ratnahartayu/waterflow-meter/dokumen/Proposal Sistem Monitoring Toren Air Desa Berbasis IoT.docx

PROPOSAL

Sistem Monitoring Toren Air Desa Berbasis IoT

Pemantauan jarak jauh air masuk, air keluar, dan isi toren di lima desa Kabupaten Tuban

Disusun oleh

Ir. Ratna Hartayu, M.T.

Program Studi S1 Teknik Elektro

Fakultas Teknologi Elektro dan Informatika Cerdas

Universitas 17 Agustus 1945 Surabaya

Oktober 2026

# 1. Ringkasan

Proposal ini mengajukan pemasangan sistem monitoring berbasis IoT pada lima toren air bersih di lima desa Kabupaten Tuban (Mander, Bader, Tuwiri Kulon, Kabluan, dan Ngulahan), dengan biaya dasar sekitar Rp4,9 juta per lokasi, total Rp28,9 juta termasuk perjalanan tim dan cadangan komponen, dan anggaran yang diajukan Rp33,2 juta setelah cadangan risiko dan cadangan manajemen dihitung dengan metode manajemen proyek. Tiap toren diberi tiga titik ukur: meter air masuk dari pompa, meter air keluar ke warga, dan sensor isi toren. Dari ketiganya server menghitung neraca air harian, sehingga pengelola tahu bukan hanya berapa air yang dipakai warga, tetapi juga apakah air yang dipompa sampai ke warga atau hilang di toren. Semua dipantau dari ponsel lewat dashboard dan grup Telegram.

# 2. Latar belakang

Di lima desa mitra, air bersih bersumber dari sumur bor bantuan Rotary. Pompa listrik PLN di rumah pompa mengisi toren plastik 2.000 liter di atas atapnya, lalu air mengalir secara gravitasi ke rumah warga lewat pipa ½ sampai 1½ inci. Pengelola di tiap desa belum punya catatan berapa air yang dipompa, berapa yang sampai ke warga, dan berapa lama pompa bekerja setiap hari. Pemakaian hanya diketahui dari seberapa sering pompa menyala dan dari keluhan warga saat air tidak sampai ke rumah paling ujung.

Tanpa data, beberapa masalah sulit dikenali. Kebocoran pipa distribusi baru ketahuan setelah tanah becek. Toren yang rembes atau luber karena pelampung rusak membuang air dan listrik tanpa ada yang tahu. Iuran air dipukul rata tanpa dasar volume. Pengelola juga tidak bisa membedakan pompa yang bekerja normal dengan pompa yang berputar tanpa mengangkat air karena sumur mengering.

Dengan toren sekecil 2.000 liter dan pemakaian harian 4 sampai 12 m³, pompa mengisi ulang beberapa kali sehari. Setiap siklus pengisian adalah kesempatan untuk mencocokkan air yang dipompa dengan kenaikan isi toren, dan setiap malam adalah kesempatan untuk memastikan toren tidak bocor saat tidak ada yang memakai air. Monitoring jarak jauh membuat pencocokan itu berjalan otomatis di lima desa yang berjauhan tanpa petugas harus datang.

# 3. Tujuan dan manfaat

Kegiatan ini bertujuan memasang dan mengoperasikan sistem monitoring toren di lima desa serta melatih pengelola tiap desa membaca dan memanfaatkan datanya. Sasaran yang ingin dicapai:

1. Tersedianya catatan harian air masuk dari pompa, air keluar ke warga, dan isi toren di tiap desa dengan ketelitian 10 liter.
2. Neraca air harian tiap toren terhitung otomatis dan selisih di atas 4 persen dilaporkan ke pengelola.
3. Peringatan otomatis lewat Telegram saat ada aliran malam mencurigakan, toren bocor, toren luber, pompa bekerja tanpa hasil, atau aliran berhenti di siang hari.
4. Sepuluh orang pengelola (dua per desa) terlatih mengoperasikan dashboard dan merawat alat sendiri.

Manfaat bagi pengelola air desa: dasar yang terukur untuk iuran, deteksi dini kebocoran dan luapan, serta data jam kerja pompa untuk memperkirakan biaya listrik dan umur pompa. Manfaat bagi warga: pasokan lebih stabil karena gangguan cepat diketahui, iuran lebih adil. Manfaat bagi perguruan tinggi: lima lokasi penerapan nyata untuk riset dan tugas akhir mahasiswa di bidang IoT dan sistem kendali, dengan model yang bisa direplikasi ke desa lain.

# 4. Gambaran sistem

Pada tiap toren dipasang tiga alat ukur yang terhubung ke satu node ESP32 di dalam rumah pompa. Node mengirim data setiap 15 menit lewat jaringan 4G ke server, dan server menghitung neraca air: air masuk dikurangi air keluar harus sama dengan perubahan isi toren. Selisih yang menetap berarti toren bocor, luber, atau salah satu meteran bermasalah (Gambar 1).

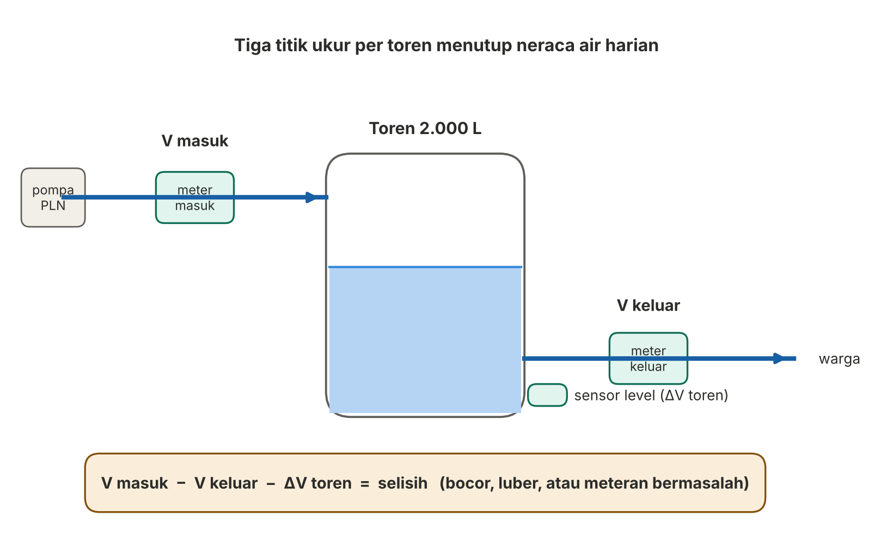
[picture p1: figure]

Gambar 1. Neraca air toren dengan tiga titik ukur

Tiga pengukuran diperlukan karena dengan dua saja persamaannya tidak tertutup. Bila hanya level dan meter keluar, air masuk bisa dihitung dari kenaikan level, tetapi kebocoran toren ikut tersembunyi di dalamnya. Bila hanya meter masuk dan keluar, air yang hilang tidak bisa dibedakan dari air yang memang sedang tersimpan. Gambar 2 memperlihatkan susunan sistem dalam empat lapisan dan Gambar 3 blok diagram perangkat keras di rumah pompa.

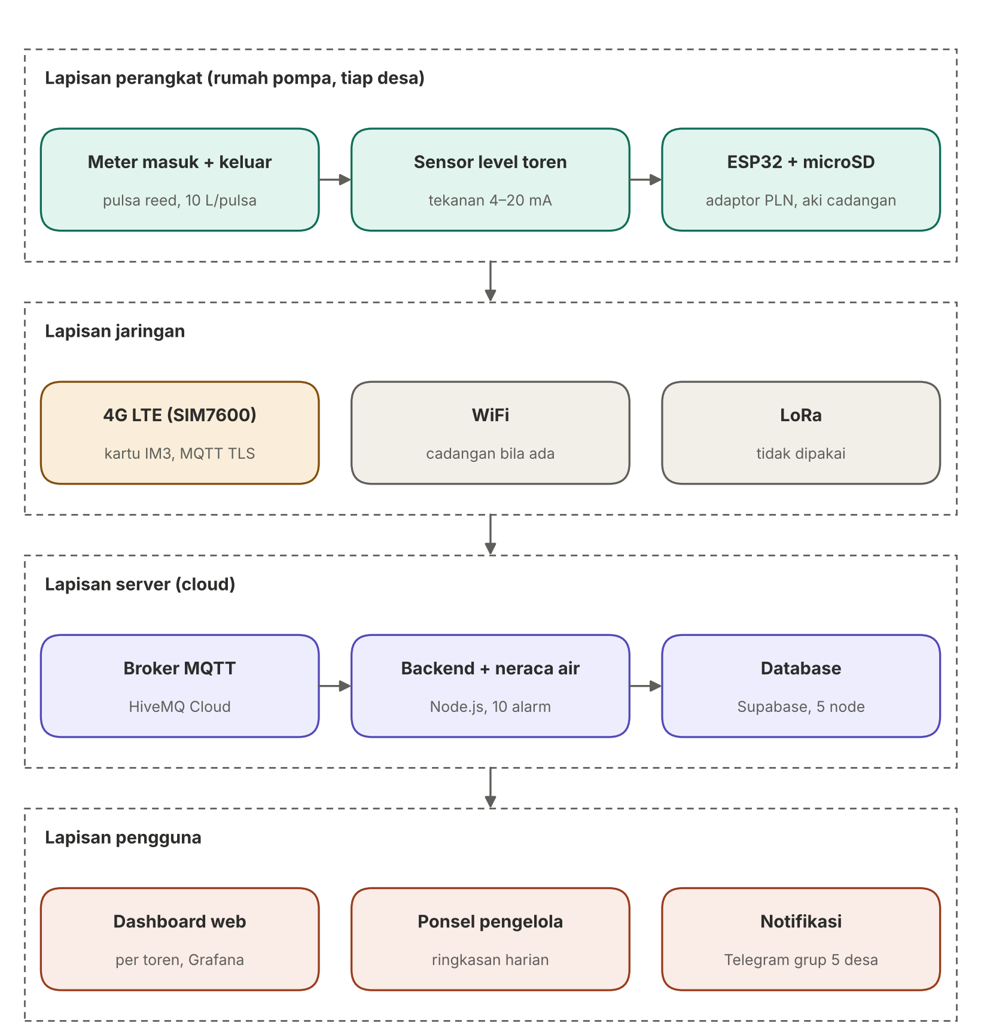
[picture p2: figure]

Gambar 2. Arsitektur sistem dalam empat lapisan

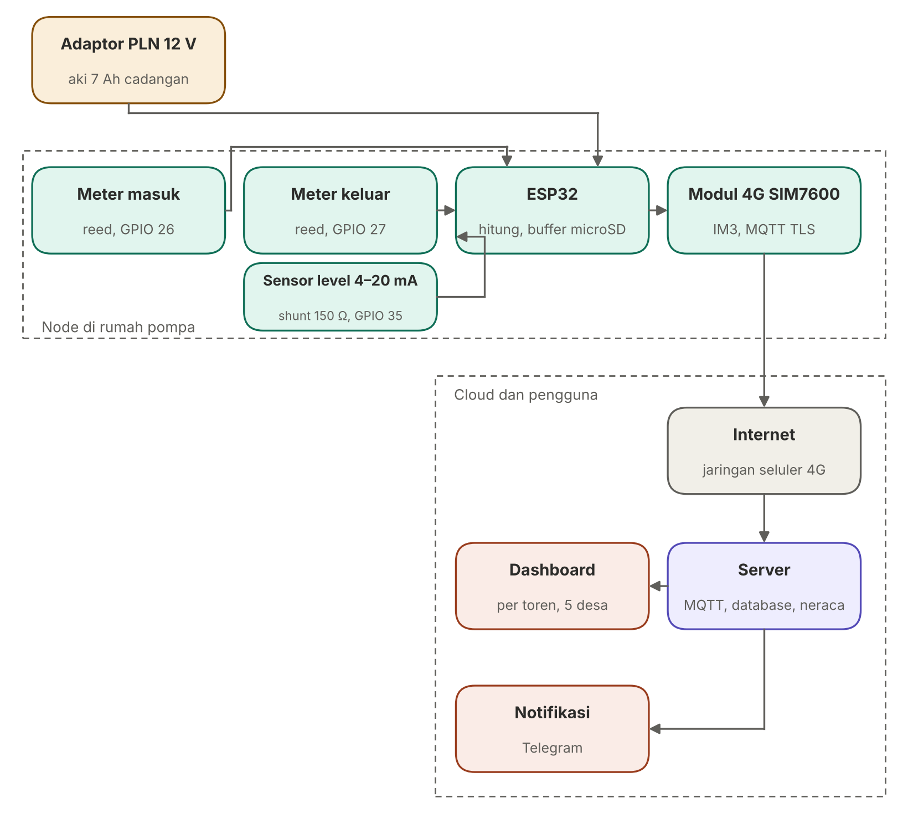
[picture p3: figure]

Gambar 3. Blok diagram perangkat keras dan hubungan ke server

## Alur kerja di sisi perangkat

Kedua water meter mengeluarkan satu pulsa setiap 10 liter. ESP32 menghitung pulsa dari masing-masing meter lewat interrupt, membaca sensor level toren lewat loop 4 sampai 20 mA, dan menandai pompa hidup bila ada aliran masuk. Setiap 15 menit node mengirim paket berisi volume keluar, volume masuk, isi toren, status pompa, tegangan aki cadangan, dan kuat sinyal ke broker MQTT. Bila sinyal hilang, paket disimpan di microSD dan dikirim ulang saat sinyal kembali (Gambar 4).

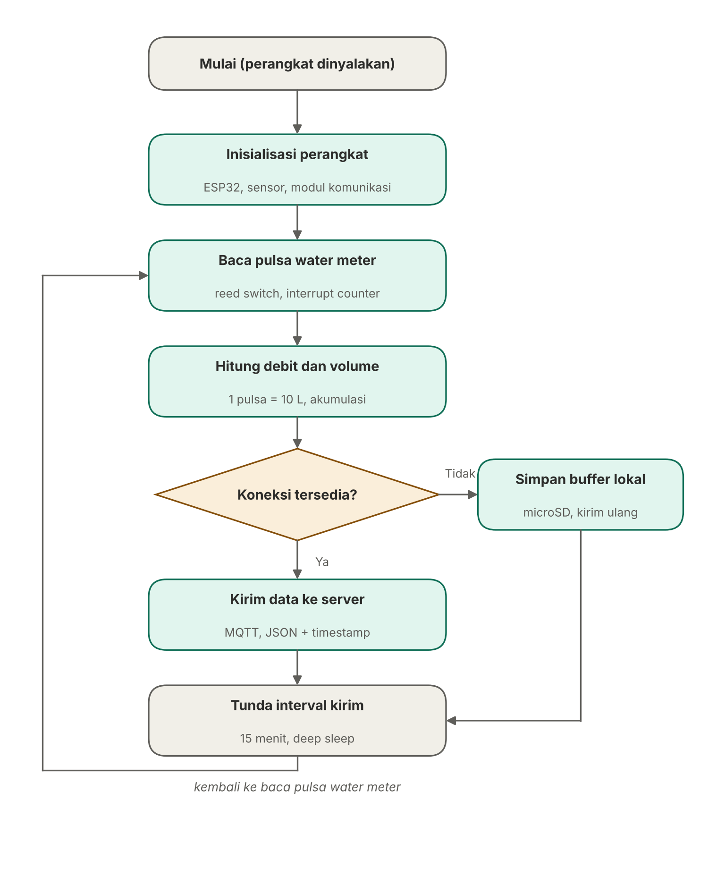
[picture p4: figure]

Gambar 4. Flowchart node di rumah pompa

## Alur kerja di sisi server

Backend menyimpan setiap paket ke database, lalu memeriksa kondisi per paket dan per hari (Gambar 5). Per paket: aliran malam ke warga di atas 2 liter/menit (pipa distribusi bocor), isi toren turun saat pompa mati dan tidak ada aliran keluar (toren bocor), toren penuh tetapi pompa masih mengisi (luber, pelampung rusak), meter masuk mencatat air tetapi toren tidak naik sepadan (pompa tanpa hasil), serta aliran nol lebih dari 3 jam di siang hari. Per hari pukul 06.30 WIB: neraca air dengan toleransi 4 persen dan lonjakan pemakaian di atas 150 persen rata-rata tujuh hari. Setiap kondisi dikirim sekali ke grup Telegram sampai normal kembali, dan ringkasan harian tiap toren memuat air keluar, air masuk, jam pompa, selisih neraca, dan hasil uji malam.

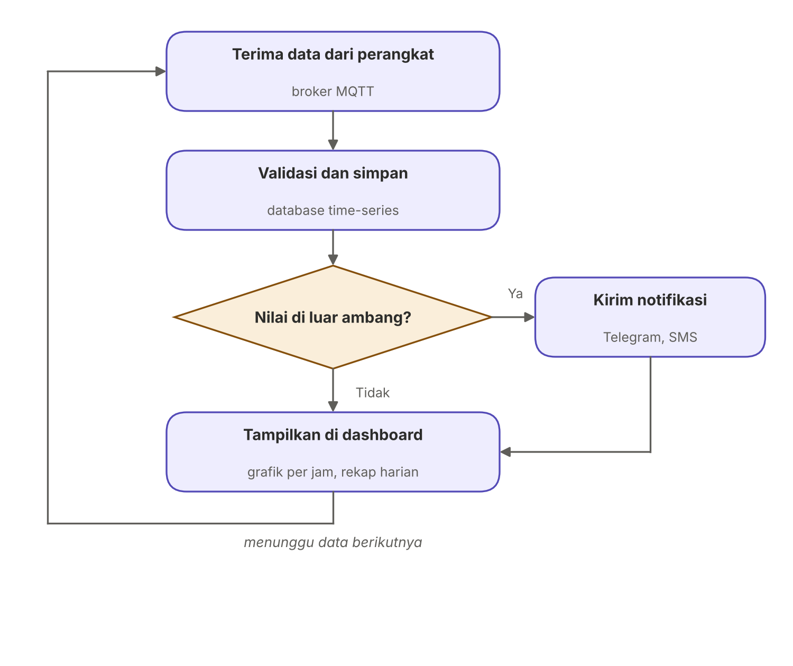
[picture p5: figure]

Gambar 5. Flowchart pengolahan data di server

# 5. Lokasi dan ukuran alat

Kelima toren berjenis sama, plastik Hidro 2.000 liter di atas rumah pompa, dengan pompa dan listrik dari PLN serta sinyal seluler IM3. Ukuran meter mengikuti pipa di tiap lokasi sesuai hasil survei.

Lokasi (desa, kecamatan) | Pipa masuk (pompa) | Meter masuk | Pipa keluar (warga) | Meter keluar
Mander, Tambakboyo | ¾ inci | DN20 | 1½ inci | DN40
Bader, Jatirogo | 1 inci | DN25 | 1½ inci | DN40
Tuwiri Kulon, Merakurak | 1 inci | DN25 | ½ inci | DN15
Kabluan, Bangilan | ¾ inci | DN20 | 1½ inci | DN40
Ngulahan, Tambakboyo | 1 inci | DN25 | 1½ inci | DN40

Meter keluar dipilih sesuai pipa, bukan dibesarkan: meter yang terlalu besar tidak membaca aliran kecil di malam hari. Di Tuwiri Kulon pipa keluarnya ½ inci sehingga cukup DN15, yang justru paling peka di aliran rendah.

# 6. Spesifikasi teknis

Komponen dipilih untuk kondisi lapangan: rumah pompa berlistrik PLN, air sumur yang membawa pasir, lima lokasi berjauhan, dan perawatan oleh warga sendiri.

Bagian | Pilihan | Alasan
Meter keluar | Water meter multi-jet kuningan DN40 (DN15 di Tuwiri Kulon), kelas B tera ISO 4064, modul pulsa reed 10 L/pulsa | Membaca aliran kecil malam hari; tahan pasir; tidak butuh daya; angka sah untuk dasar iuran
Meter masuk | Water meter multi-jet kuningan DN20 (pipa ¾ inci) atau DN25 (pipa 1 inci), kelas B, modul pulsa 10 L/pulsa | Mencatat air yang dipompa dan jam kerja pompa; kelas yang sama dengan meter keluar agar kesalahan seimbang
Sensor level | Tekanan hidrostatik 0–2 mH₂O, keluaran 4–20 mA, dipasang lewat tee di nipel bawah toren | Resolusi sekitar 5 liter pada toren 2.000 L; tidak terganggu embun atau riak; kabel putus terdeteksi (arus di bawah 4 mA)
Pengaman | Strainer Y di hulu meter keluar, pipa lurus 5D sebelum dan 3D sesudah meter | Mencegah pasir masuk ke impeler dan aliran turbulen
Mikrokontroler | ESP32 DevKit V1, dua interrupt pulsa dengan debounce 20 ms, ADC untuk level dan aki | Murah, cukup pin, tidur ringan di antara pengiriman
Penyimpanan lokal | Modul microSD 8 GB dan RTC DS3231 | Data tetap tercatat dengan waktu benar saat sinyal hilang
Komunikasi | Modul 4G SIM7600 dengan kartu IM3, MQTT dengan TLS port 8883, kirim tiap 15 menit | Jaringan 2G Indosat sudah ditinggalkan; 4G aman beberapa tahun dan mendukung enkripsi; kuota sekitar 1 MB per bulan
Catu daya | Adaptor 12 V dari PLN rumah pompa, modul charger, aki VRLA 7 Ah cadangan, step-down 5 V | Rumah pompa sudah berlistrik; aki menjaga node tetap hidup lebih dari sehari saat PLN padam
Kotak | Box panel IP65 di dalam rumah pompa | Kering, terkunci, jauh dari jangkauan anak-anak
Server | HiveMQ Cloud (broker), Supabase (database), Grafana Cloud (dashboard), bot Telegram | Paket gratis cukup untuk lima node; satu dashboard dengan pilihan toren

Format data tiap 15 menit: ID node, waktu (UTC), volume keluar dan kumulatifnya, volume masuk dan kumulatifnya, debit keluar dan masuk, tinggi air dan isi toren, status pompa, tegangan aki, dan kuat sinyal. Ukuran satu paket sekitar 200 byte. Ketelitian neraca mengikuti dua meteran kelas B (±2 persen masing-masing) dan sensor level (±0,5 persen), sehingga selisih harian sampai 4 persen dari air masuk masih dianggap wajar.

# 7. Rencana anggaran biaya

Biaya satu lokasi lengkap, terpasang dan berjalan, sekitar Rp4,9 juta untuk toren dengan keluaran 1½ inci dan Rp3,85 juta untuk Tuwiri Kulon. Harga mengacu pada marketplace Indonesia per Oktober 2026 dan dapat bergeser 10 sampai 20 persen.

No | Komponen per lokasi | Spesifikasi | Jml | Harga satuan (Rp) | Subtotal (Rp)
1 | Water meter keluar multi-jet kuningan | DN40 kelas B + modul pulsa 10 L (DN15 untuk Tuwiri Kulon) | 1 | 1.600.000 | 1.600.000
2 | Water meter masuk multi-jet kuningan | DN20 atau DN25 kelas B + modul pulsa 10 L | 1 | 1.050.000 | 1.050.000
3 | Strainer Y kuningan | 1,5 inci (½ inci untuk Tuwiri Kulon) | 1 | 200.000 | 200.000
4 | Sensor level tekanan hidrostatik | 0–2 mH₂O, 4–20 mA, G½, dengan tee dan shunt | 1 | 280.000 | 280.000
5 | Fitting, union, tee, seal tape, lem | Sambungan dua meter dan sensor | 1 set | 200.000 | 200.000
6 | ESP32 DevKit V1 | 30 pin | 1 | 75.000 | 75.000
7 | Modul 4G SIM7600 dan antena | LTE Cat-1, TLS | 1 | 500.000 | 500.000
8 | Kartu SIM IM3 | Paket data 1 GB per bulan | 1 | 50.000 | 50.000
9 | Modul RTC DS3231 dan microSD 8 GB | | 1 set | 85.000 | 85.000
10 | PCB, resistor, kapasitor, terminal | | 1 set | 50.000 | 50.000
11 | Adaptor 12 V 2 A, modul charger, aki VRLA 7 Ah, 2 step-down | Catu daya PLN dengan cadangan | 1 set | 390.000 | 390.000
12 | Box panel IP65, kabel, klem | Dipasang di dalam rumah pompa | 1 set | 220.000 | 220.000
13 | Jasa tukang pipa | Pemasangan dua meter, tee sensor | 1 | 250.000 | 250.000
| Per lokasi (keluaran DN40) | | | | 4.950.000

Lokasi | Meter keluar | Meter masuk | Biaya lokasi (Rp)
Mander, Tambakboyo | DN40 | DN20 | 4.900.000
Bader, Jatirogo | DN40 | DN25 | 4.950.000
Tuwiri Kulon, Merakurak | DN15 | DN25 | 3.850.000
Kabluan, Bangilan | DN40 | DN20 | 4.900.000
Ngulahan, Tambakboyo | DN40 | DN25 | 4.950.000
Lima lokasi | | | 23.550.000
Perjalanan tim Surabaya–Tuban (survei, pemasangan, pelatihan; 3 kunjungan ke 5 desa) | | | 4.500.000
Total | | | 28.050.000

Biaya rutin setelah pemasangan hanya pulsa data lima kartu, sekitar Rp250.000 per bulan, ditanggung dari kas pengelola air tiap desa. Server memakai paket gratis sehingga tidak ada biaya hosting.

## Perhitungan cadangan dengan konsep manajemen proyek

Angka di atas adalah estimasi bottom-up dalam kondisi semua berjalan sesuai rencana. Dalam praktik, barang bisa terlambat datang, tukang pipa atau anggota tim bisa tidak hadir sehingga harus dicari pengganti dengan tarif lebih tinggi, dan harga bisa naik. Mengikuti praktik manajemen proyek (PMBOK), anggaran disusun dalam tiga lapis: biaya dasar, cadangan risiko (contingency reserve) untuk risiko yang sudah teridentifikasi, dan cadangan manajemen (management reserve) untuk hal yang belum teridentifikasi.

Cadangan risiko dihitung dari daftar risiko dengan metode nilai harapan: setiap risiko diberi peluang terjadi dan dampak biaya bila terjadi, lalu nilai harapan = peluang × dampak. Dampak dihitung dari biaya nyata yang akan timbul, misalnya selisih tarif tukang pengganti ditambah biaya tim menunggu, atau satu kunjungan tambahan bila komponen tertinggal. Jumlah seluruh nilai harapan menjadi cadangan risiko.

ID | Risiko | Cara menghitung dampak | Peluang | Dampak (Rp) | Nilai harapan (Rp)
R1 | Komponen terlambat datang (meter, sensor level, modul 4G) | Satu kunjungan tambahan untuk memasang komponen yang tertinggal | 30 % | 1.500.000 | 450.000
R2 | Komponen rusak saat datang atau saat uji | Harga pengganti dan ongkir kilat | 25 % | 600.000 | 150.000
R3 | Tukang pipa tidak hadir, pengganti lokal lebih mahal | Selisih tarif pengganti (450.000 − 250.000) + setengah hari tim menunggu (200.000), dua kunjungan | 40 % | 800.000 | 320.000
R4 | Anggota tim mahasiswa tidak hadir atau mengundurkan diri | Honor asisten lapangan pengganti satu kunjungan + lembur perakitan | 30 % | 750.000 | 225.000
R5 | Sinyal IM3 lemah di salah satu rumah pompa | Antena eksternal dan kabel + kunjungan ulang sebagian | 40 % | 700.000 | 280.000
R6 | Ukuran pipa di lapangan berbeda dari catatan survei | Beli ulang satu meter dan modul pulsa | 20 % | 1.200.000 | 240.000
R7 | Kenaikan harga komponen atau ongkos kirim | 10 % dari 60 % komponen yang belum terbeli | 40 % | 1.200.000 | 480.000
R8 | Akses lokasi tertunda (izin desa, hujan, jalan rusak) | Satu kunjungan ulang | 25 % | 1.500.000 | 375.000
R9 | Kalibrasi level gagal, sensor tidak cocok nipel toren | Fitting adaptor + setengah hari kerja | 30 % | 500.000 | 150.000
| Cadangan risiko | | | | 2.670.000

Mitigasi yang biayanya sudah dimasukkan ke biaya dasar: satu unit cadangan sensor level, modul 4G, dan ESP32 (Rp855.000) agar komponen rusak atau terlambat tidak menunda pemasangan; kontrak tukang pipa dengan uang muka dan dua kontak per desa; tim empat orang untuk kebutuhan tiga; pembelian komponen utama di minggu pertama setelah dana cair. Dampak jadwal tiap risiko dihitung dengan cara yang sama dan menghasilkan buffer jadwal sekitar dua minggu, sehingga bila terpakai laporan bergeser dari akhir Januari ke pertengahan Februari 2027.

Komponen anggaran | Nilai (Rp)
Biaya dasar: lima lokasi 23.550.000 + perjalanan 4.500.000 + cadangan komponen 855.000 | 28.905.000
Cadangan risiko (contingency reserve), jumlah nilai harapan, 9,2 % biaya dasar | 2.670.000
Cost baseline = biaya dasar + cadangan risiko | 31.575.000
Cadangan manajemen (management reserve) 5 % cost baseline, untuk risiko yang belum teridentifikasi | 1.578.750
Anggaran total yang diajukan (dibulatkan ke atas Rp100.000) | 33.200.000

Aturan pemakaiannya: cadangan risiko dipakai ketua tim untuk risiko yang ada di daftar dan dicatat dalam log proyek (tanggal, risiko, nominal); cadangan manajemen hanya dipakai untuk kejadian di luar daftar dengan persetujuan LPPM; sisa cadangan yang tidak terpakai dikembalikan atau dialihkan ke tahap lanjutan dengan persetujuan pemberi dana. Tiap akhir minggu biaya aktual dibandingkan dengan cost baseline untuk melihat apakah cadangan mulai terpakai. Lembar kerja perhitungan (peluang, dampak, nilai harapan) disertakan sebagai file Excel berformula sehingga angkanya bisa disesuaikan saat survei.

# 8. Jadwal pelaksanaan

Kegiatan berjalan dua belas minggu dari awal November 2026. Survei kelima lokasi dilakukan dalam satu kunjungan, perakitan lima node dikerjakan di laboratorium kampus, pemasangan dua kunjungan (tiga lokasi lalu dua lokasi), uji coba dua minggu, pelatihan pengelola bersamaan dengan kunjungan terakhir, dan laporan selesai akhir Januari 2027 (Gambar 6).

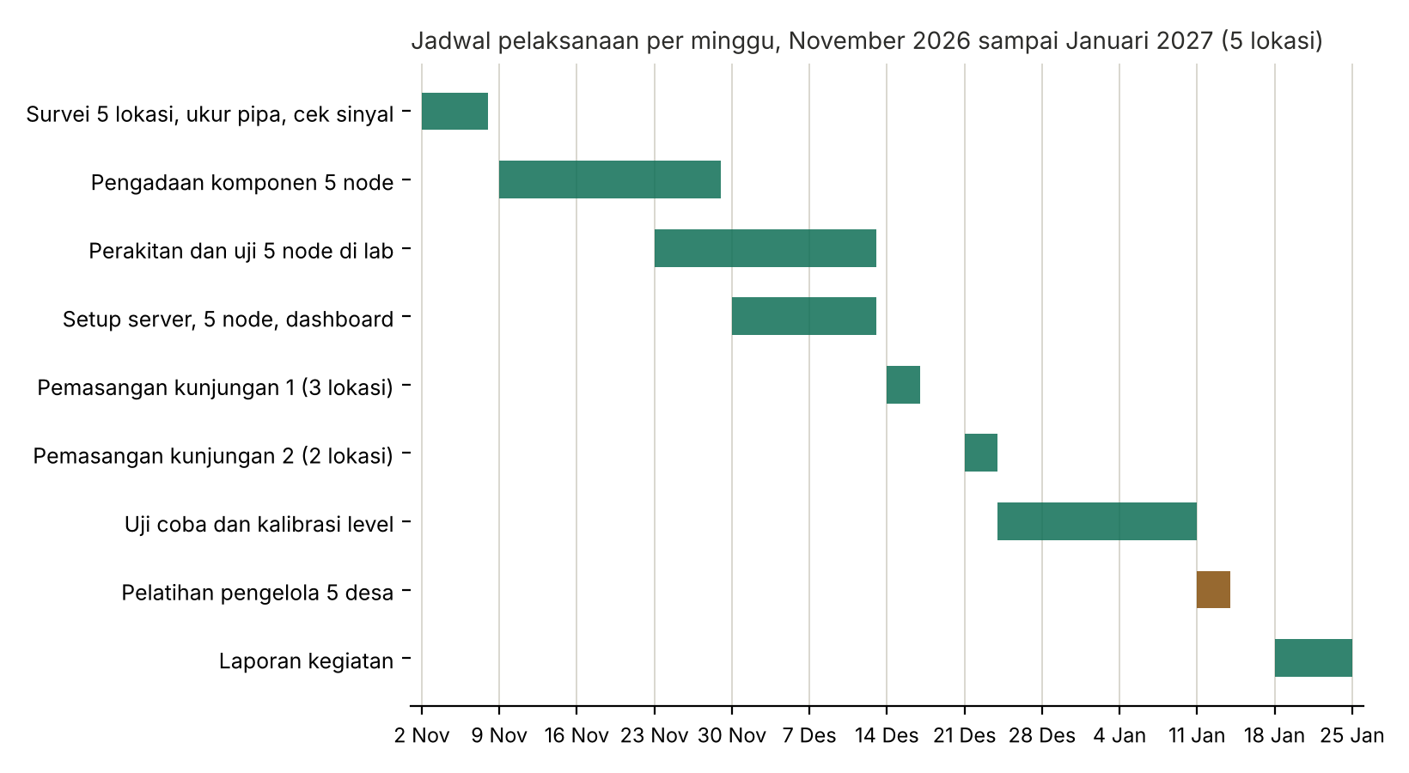
[picture p6: figure]

Gambar 6. Jadwal pelaksanaan per minggu

Uji coba dua minggu dipakai untuk memastikan data lima node terkirim stabil, mencocokkan angka meter dengan dial, mengkalibrasi sensor level pada toren kosong dan penuh, dan menyetel ambang alarm sesuai pola pemakaian tiap desa.

# 9. Keberlanjutan dan peran mitra

Alat dirancang agar dirawat warga sendiri. Perawatan rutin hanya tiga hal: membersihkan strainer sebulan sekali, memeriksa tegangan aki cadangan dari dashboard, dan mengisi pulsa data tiap bulan. Semua komponen tersedia di marketplace, dan dokumentasi pemasangan serta kode program diserahkan ke pengelola.

Peran mitra desa: menunjuk dua pengelola per desa yang mengikuti pelatihan, menyediakan akses ke rumah pompa saat pemasangan, menanggung pulsa data dari kas air, dan menyampaikan keluhan lewat grup Telegram bersama tim pelaksana selama satu tahun pendampingan.

Peran tim pelaksana: survei, perakitan, pemasangan, pelatihan, dan pendampingan jarak jauh selama satu tahun. Mahasiswa dilibatkan dalam perakitan dan pengujian sebagai bagian dari tugas akhir dan praktik lapangan.

Tahap lanjutan yang bisa diajukan terpisah: meteran per rumah di desa dengan jumlah pelanggan terbanyak, agar selisih antara meter induk dan jumlah meter rumah menunjukkan kebocoran jaringan distribusi.

## Risiko dan penanganannya

Risiko | Penanganan
Sinyal 4G lemah di salah satu desa | Survei sinyal IM3 saat kunjungan pertama; antena eksternal di luar rumah pompa; data tetap tersimpan di microSD
Pasir menyumbat meteran | Strainer Y di hulu, dibersihkan bulanan oleh pengelola
Listrik PLN padam lama | Aki 7 Ah menahan node lebih dari sehari; alarm tegangan rendah; saat pompa pun mati, tidak ada air yang perlu dicatat
Sensor level bergeser atau kotor | Kalibrasi ulang dua titik (kosong dan penuh) saat kunjungan; alarm bila arus loop di bawah 4 mA
Pencurian atau vandalisme | Semua alat di dalam rumah pompa yang terkunci; sosialisasi ke warga
Pengelola tidak membuka dashboard | Ringkasan harian tiap toren dikirim otomatis ke grup Telegram tiap pagi

# 10. Penutup

Dengan anggaran Rp33,2 juta (termasuk cadangan risiko dan cadangan manajemen) dan waktu dua belas minggu ditambah buffer dua minggu, pengelola air di lima desa memperoleh catatan air masuk, air keluar, dan isi toren yang akurat, peringatan dini kebocoran dan luapan, serta dasar yang adil untuk iuran, tanpa perlu datang ke rumah pompa setiap hari. Kami mengharapkan dukungan untuk melaksanakan kegiatan ini dan terbuka menyesuaikan rancangan dengan kondisi lapangan setelah survei.

Data yang masih perlu dipastikan saat survei: jumlah rumah tersambung di tiap desa, kuat sinyal IM3 di rumah pompa, dan jenis pelampung atau saklar otomatis pompa yang terpasang.

Hormat kami,

Ir. Ratna Hartayu, M.T.

Program Studi S1 Teknik Elektro, Fakultas Teknologi Elektro dan Informatika Cerdas

Universitas 17 Agustus 1945 Surabaya

rhartayu@untag-sby.ac.id

# Lampiran 1. Alat ukur: water meter multi-jet kuningan dengan modul pulsa

Lampiran ini menjelaskan alat ukur yang diusulkan dan cara kerjanya, dari air yang masuk sampai pulsa yang dihitung ESP32.

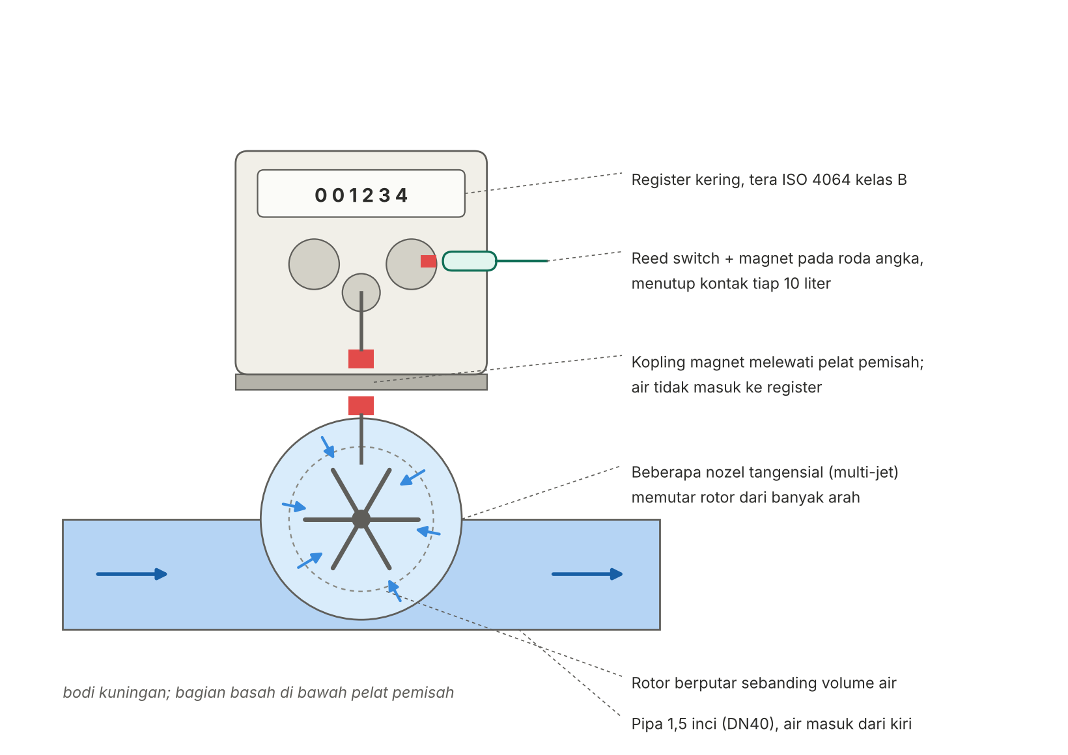
[picture p7: figure]

Gambar L1. Potongan skematik water meter multi-jet dengan modul pulsa reed switch

## Spesifikasi yang diusulkan

Parameter | Nilai
Tipe | Multi-jet, register kering, bodi kuningan
Ukuran | DN40 (1,5 inci), ulir G1½ B; DN50 bila pipa 2 inci
Kelas ketelitian | Kelas B (ISO 4064) atau R160; ±5% di aliran rendah, ±2% di rentang kerja
Debit nominal (Q3) | 10 m³/jam untuk DN40; aliran minimum terbaca sekitar 80 sampai 100 liter/jam
Tekanan kerja | Maksimum 16 bar
Suhu air | Air dingin, 0,1 sampai 50 °C
Modul pulsa | Reed switch, kontak kering, 1 pulsa per 10 liter (opsi 1 liter)
Contoh merek | Onda, Amico, Barindo, Itron Aquadis+ / Flodis (versi pulse ready)

## Cara kerja

Air masuk dari pipa ke ruang ukur silinder di dalam bodi kuningan. Dinding ruang ukur memiliki beberapa lubang miring (nozel) yang mengarahkan air secara tangensial ke rotor dari berbagai sisi sekaligus, karena itu disebut multi-jet. Dorongan dari banyak arah membuat rotor tetap berputar pada aliran kecil dan keausan porosnya merata. Jumlah putaran rotor sebanding dengan volume air yang lewat.

Bagian atas meteran kering. Rotor di bagian basah dan roda gigi register di bagian kering dipisahkan oleh pelat, dan putaran disalurkan lewat sepasang magnet yang saling tarik menembus pelat itu. Air, pasir, dan lumut tidak pernah menyentuh roda gigi dan angka, sehingga kaca penunjuk tidak berembun dan mekanisme tidak macet. Roda gigi menurunkan putaran rotor sampai menggerakkan deretan roda angka pada dial.

Modul pulsa memanfaatkan roda angka tersebut. Pada roda puluhan liter ditanam sebuah magnet kecil, dan di sebelahnya dipasang reed switch, yaitu dua lidah logam dalam tabung kaca yang menutup saat ada medan magnet. Setiap roda itu berputar satu kali, magnet lewat di depan reed switch dan kontaknya menutup sesaat lalu membuka lagi. Satu kali tutup-buka itulah satu pulsa, dan karena roda tersebut berputar satu kali tiap 10 liter, satu pulsa berarti 10 liter.

## Penyambungan ke ESP32

Keluaran reed switch hanya kontak kering tanpa tegangan. Satu kabel reed disambung ke ground, kabel lainnya ke pin masukan ESP32 yang diberi resistor pull-up 10 kΩ ke 3,3 V. Saat kontak menutup, pin jatuh ke 0 V dan interrupt menghitungnya. Debounce 20 ms diperlukan karena lidah logam bergetar sesaat ketika menutup dan bisa terbaca dua kali. Frekuensi pulsa sangat rendah, paling cepat satu pulsa tiap beberapa detik pada jam puncak, sehingga tidak membebani mikrokontroler.

## Catatan pengadaan dan pemasangan

1. Pastikan meteran versi pulse ready atau reed switch sudah terpasang dari pabrik; tidak semua tipe bisa ditambah modul belakangan.
2. Angka liter per pulsa harus tertulis di spesifikasi dan dicocokkan dengan konstanta di program ESP32.
3. Pasang strainer Y di hulu, pipa lurus minimal 5 kali diameter sebelum meteran dan 3 kali sesudahnya, posisi horizontal dengan dial menghadap ke atas.
4. Arah panah pada bodi mengikuti arah aliran dari tandon ke warga; pipa harus selalu terisi penuh agar gelembung udara tidak ikut terhitung.
