ratnahartayu/waterflow-meter/dokumen/RAB Monitoring Toren Desa dengan Cadangan Risiko.xlsx

Sheet: Biaya dasar
Biaya dasar (estimasi bottom-up) per lokasi
Sel biru = angka masukan yang boleh diubah; sel hitam = rumus. Harga marketplace Indonesia, Oktober 2026.
No | Komponen per lokasi | Spesifikasi | Jml | Harga satuan (Rp) | Subtotal (Rp)
1 | Water meter keluar multi-jet kuningan | DN40 kelas B + modul pulsa 10 L | 1 | Rp 1600000 | Rp 1600000
2 | Water meter masuk multi-jet kuningan | DN20/DN25 kelas B + modul pulsa 10 L | 1 | Rp 1050000 | Rp 1050000
3 | Strainer Y kuningan | 1,5 inci | 1 | Rp 200000 | Rp 200000
4 | Sensor level tekanan hidrostatik | 0–2 mH2O, 4–20 mA, tee dan shunt | 1 | Rp 280000 | Rp 280000
5 | Fitting, union, tee, seal tape, lem |  | 1 | Rp 200000 | Rp 200000
6 | ESP32 DevKit V1 |  | 1 | Rp 75000 | Rp 75000
7 | Modul 4G SIM7600 dan antena |  | 1 | Rp 500000 | Rp 500000
8 | Kartu SIM IM3 | paket 1 GB | 1 | Rp 50000 | Rp 50000
9 | Modul RTC DS3231 dan microSD 8 GB |  | 1 | Rp 85000 | Rp 85000
10 | PCB, resistor, kapasitor, terminal |  | 1 | Rp 50000 | Rp 50000
11 | Adaptor 12 V, charger, aki 7 Ah, 2 step-down | catu daya PLN + cadangan | 1 | Rp 390000 | Rp 390000
12 | Box IP65, kabel, klem |  | 1 | Rp 220000 | Rp 220000
13 | Jasa tukang pipa | tarif rencana per lokasi | 1 | Rp 250000 | Rp 250000
 | Per lokasi dengan keluaran DN40 |  |  |  | Rp 4950000
Lokasi | Meter keluar | Meter masuk | Penyesuaian (Rp) |  | Biaya lokasi (Rp)
Mander, Tambakboyo | DN40 | DN20 | -Rp 50000 |  | Rp 4900000
Bader, Jatirogo | DN40 | DN25 | Rp 0 |  | Rp 4950000
Tuwiri Kulon, Merakurak | DN15 | DN25 | -Rp 1100000 |  | Rp 3850000
Kabluan, Bangilan | DN40 | DN20 | -Rp 50000 |  | Rp 4900000
Ngulahan, Tambakboyo | DN40 | DN25 | Rp 0 |  | Rp 4950000
Lima lokasi |  |  |  |  | Rp 23550000
Perjalanan tim Surabaya–Tuban | 3 kunjungan × 5 desa |  | 3 | Rp 1500000 | Rp 4500000
Cadangan komponen (mitigasi) | 1 sensor level, 1 modul 4G, 1 ESP32 |  |  |  | Rp 855000
BIAYA DASAR (cost estimate) |  |  |  |  | Rp 28905000

Sheet: Daftar risiko
Daftar risiko dan cadangan risiko (contingency reserve) — nilai harapan = peluang × dampak biaya
Ubah sel biru (peluang dan dampak) sesuai kondisi lapangan. Dampak = biaya tambahan bila risiko terjadi, dihitung dari rumus di kolom Cara menghitung dampak.
ID | Risiko | Pemicu / sumber | Cara menghitung dampak | Peluang | Dampak biaya (Rp) | Nilai harapan (Rp) | Dampak jadwal (hari) | Mitigasi (dicantumkan dalam biaya dasar atau rencana)
R1 | Komponen terlambat datang (water meter, sensor level, modul 4G) | Stok penjual kosong, pengiriman impor 2–4 minggu | Satu kunjungan tambahan untuk memasang komponen yang tertinggal: 1 × biaya kunjungan | 30% | Rp 1500000 | Rp 450000 | 14 | Pesan di minggu ke-2, pilih penjual stok siap, cadangan 1 unit sensor dan modul
R2 | Komponen rusak saat datang atau saat uji (DOA) | Sensor level, modul 4G | Harga pengganti + ongkir kilat: 500.000 + 100.000 | 25% | Rp 600000 | Rp 150000 | 5 | Uji semua komponen di lab sebelum berangkat; cadangan 1 unit
R3 | Tukang pipa tidak hadir saat pemasangan, pengganti lokal lebih mahal | Pelanggaran kehadiran, 2 kunjungan pemasangan | Selisih tarif pengganti (450.000 − 250.000) + setengah hari tim menunggu (200.000), per kunjungan; 2 kunjungan | 40% | Rp 800000 | Rp 320000 | 1 | Kontrak dengan uang muka, dua kontak tukang per desa, konfirmasi H-1
R4 | Anggota tim mahasiswa tidak hadir atau mengundurkan diri | Jadwal kuliah, sakit, pelanggaran kehadiran | Honor asisten lapangan pengganti 1 kunjungan 500.000 + lembur perakitan 250.000 | 30% | Rp 750000 | Rp 225000 | 3 | Tim 4 orang untuk kebutuhan 3; jadwal pemasangan di luar minggu ujian
R5 | Sinyal IM3 lemah di salah satu rumah pompa | Lokasi di lembah atau jauh dari BTS | Antena eksternal + kabel 200.000 + kunjungan ulang sebagian 500.000 | 40% | Rp 700000 | Rp 280000 | 7 | Cek sinyal saat survei; bawa antena cadangan saat pemasangan
R6 | Ukuran pipa di lapangan berbeda dari catatan survei | Catatan survei keliru, pipa sudah diganti | Beli ulang satu meter + modul pulsa 1.200.000 | 20% | Rp 1200000 | Rp 240000 | 10 | Ukur ulang dan foto pipa saat survei; beli meter setelah survei
R7 | Kenaikan harga komponen atau ongkos kirim | Kurs, harga marketplace berubah | 10% dari 60% komponen yang belum terbeli: 0,1 × 0,6 × 20.000.000 | 40% | Rp 1200000 | Rp 480000 | 0 | Beli komponen utama di minggu pertama setelah dana cair
R8 | Akses lokasi tertunda (izin desa, hujan, jalan rusak) | Musim hujan November–Januari di Tuban | Satu kunjungan ulang 1.500.000 | 25% | Rp 1500000 | Rp 375000 | 7 | Koordinasi dengan kepala desa sebelum berangkat; pemasangan 3 lokasi per kunjungan
R9 | Kalibrasi level gagal, sensor tidak cocok dengan nipel toren | Ulir nipel berbeda, toren tanpa nipel bawah | Fitting adaptor 150.000 + setengah hari kerja 350.000 | 30% | Rp 500000 | Rp 150000 | 3 | Bawa set adaptor ulir ¼, ½, ¾ inci; foto nipel saat survei
 | CADANGAN RISIKO (jumlah nilai harapan) |  |  |  |  | Rp 2670000
 | Dampak terburuk bila semua terjadi |  |  |  | Rp 8750000
 | Buffer jadwal yang disarankan (hari) = jumlah dampak jadwal × peluang |  |  |  |  |  | 14.2

Sheet: Anggaran total
Anggaran total dengan konsep manajemen proyek (PMBOK: cost baseline + management reserve)
Komponen anggaran | Nilai | Sumber
Biaya dasar (estimasi bottom-up, termasuk cadangan komponen) | Rp 28905000 | Biaya dasar
Cadangan risiko (contingency reserve) = Σ peluang × dampak dari daftar risiko | Rp 2670000 | Daftar risiko
Cadangan risiko sebagai persen biaya dasar | 9.2% | rumus
COST BASELINE = biaya dasar + cadangan risiko | Rp 31575000 | rumus
Persen cadangan manajemen (risiko yang belum teridentifikasi) | 5.0% | masukan
Cadangan manajemen (management reserve) = persen × cost baseline | Rp 1578750 | rumus
ANGGARAN TOTAL YANG DIAJUKAN = cost baseline + cadangan manajemen | Rp 33153750 | rumus
Pembulatan ke atas (Rp100.000) | Rp 33200000 | rumus
Aturan pemakaian cadangan
• Cadangan risiko dipakai ketua tim untuk risiko yang ada di daftar, dicatat tanggal, risiko, dan nominalnya di log proyek.
• Cadangan manajemen hanya dipakai untuk kejadian di luar daftar risiko, dengan persetujuan pengusul/LPPM.
• Sisa cadangan yang tidak terpakai dikembalikan atau dialihkan ke tahap lanjutan (meteran per rumah) dengan persetujuan pemberi dana.
• Setiap akhir minggu, biaya aktual dibandingkan dengan cost baseline (earned value sederhana: rencana vs realisasi) untuk melihat apakah cadangan mulai terpakai.
