ratnahartayu/waterflow-meter/(commit log)

2026-10-18 Proyek awal: firmware, backend, skema, mockup aplikasi, dokumen proposal
    [RAB Monitoring Toren Desa dengan Cadangan Risiko.xlsx]
2026-10-18 Pindah ke Firebase dan aplikasi operator desa
    - aplikasi/: aplikasi operator (6 layar sesuai mockup), Firebase Auth dengan PIN,
    Firestore, deploy ke Firebase Hosting; data contoh lewat ?contoh
    - backend: Supabase diganti Firestore, rekap harian dihitung saat paket masuk,
    pesan MQTT diproses berurutan, opsi --ringkasan
    - perbaikan: pompa_tanpa_hasil tidak lagi membandingkan paket dengan dirinya sendiri,
    ringkasan 06.30 merangkum hari kemarin
    - firestore.rules: hanya akun operator yang bisa membaca, aplikasi hanya boleh
    menandai peringatan sudah ditangani
    - hapus supabase/schema.sql
